dzwangg/SuppBuddy/hardware/cad/render/tex/breadboard.png

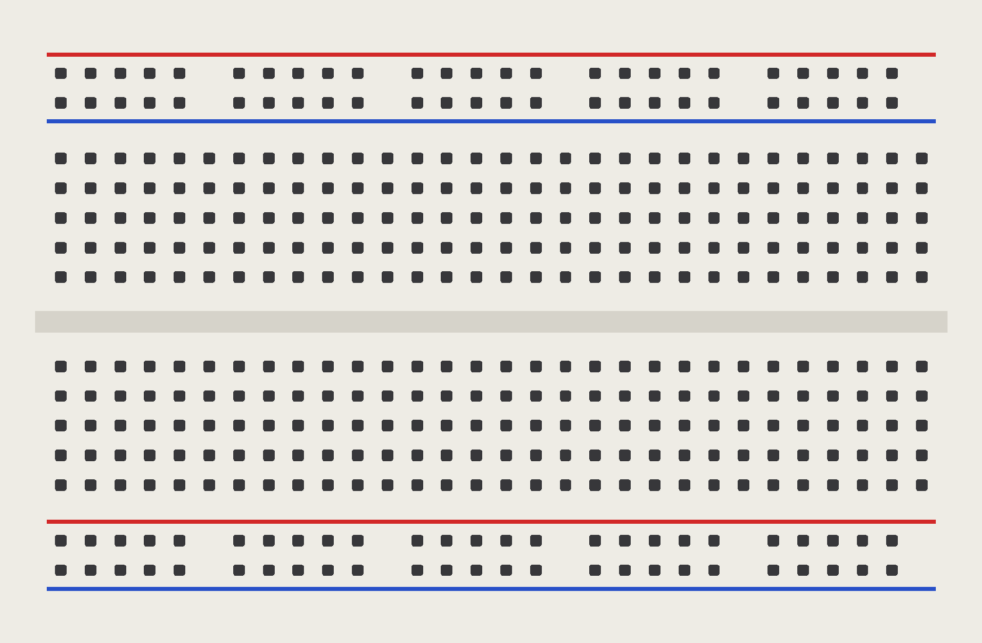
hardware/cad/render/tex/breadboard.png
