dzwangg/SuppBuddy/hardware/cad/render/tex/lcd_cutaway.png

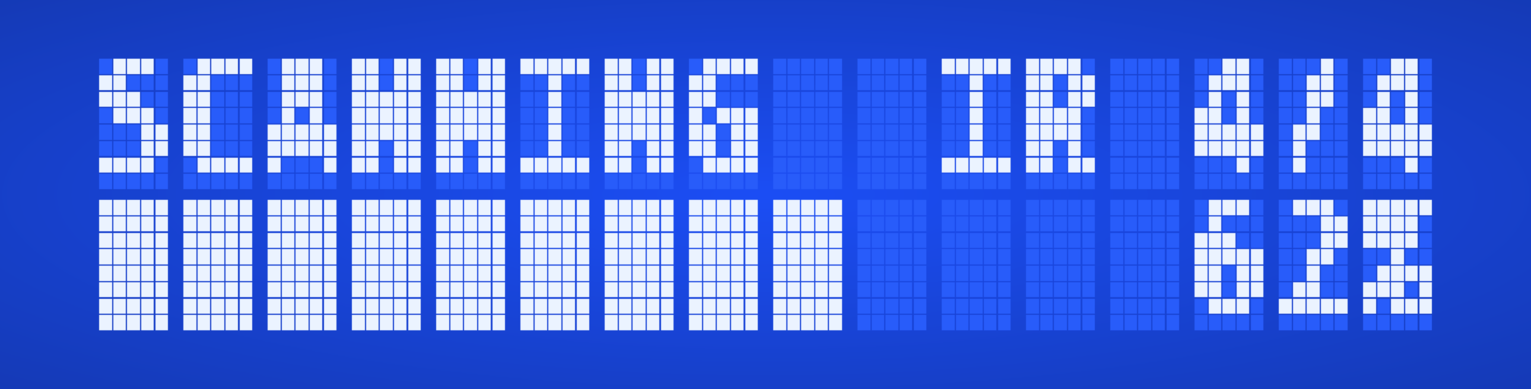
hardware/cad/render/tex/lcd_cutaway.png
