dzwangg/SuppBuddy/hardware/cad/render/tex/lcd_exploded.png

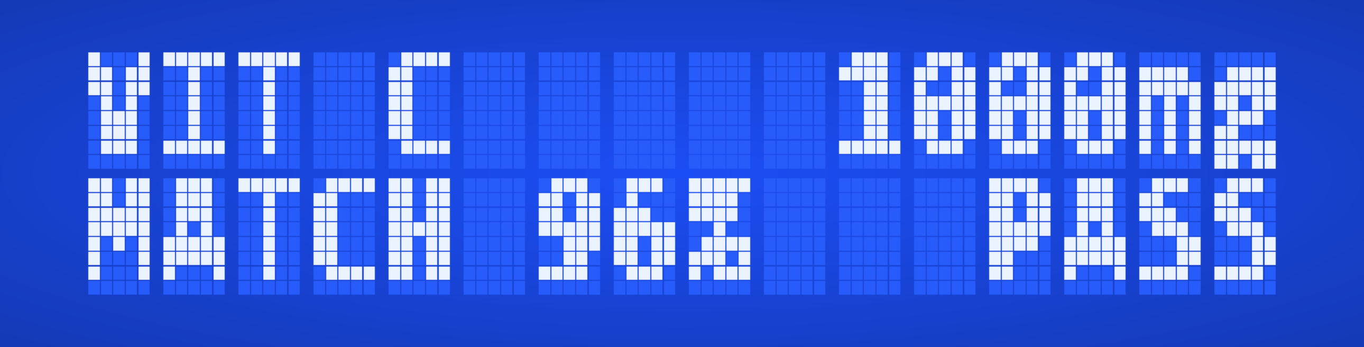
hardware/cad/render/tex/lcd_exploded.png
