dzwangg/SuppBuddy/hardware/cad/render/tex/lcd_hero.png

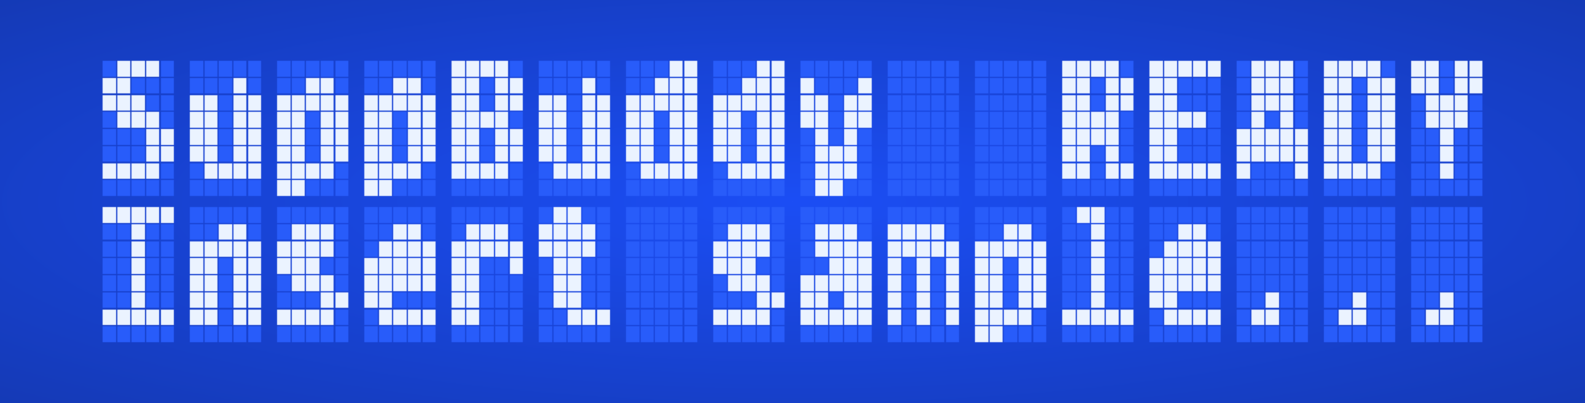
hardware/cad/render/tex/lcd_hero.png
