dzwangg/SuppBuddy/hardware/cad/render/stl/sleeve.stl

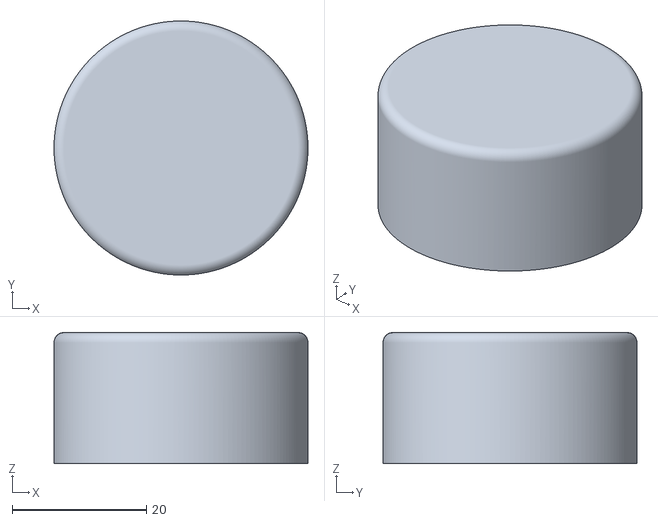
[picture p20: CAD file, 2026-11-09]
hardware/cad/render/stl/sleeve.stl
37.8 x 37.8 x 19.5
