dzwangg/SuppBuddy/hardware/stl/suppbuddy-v4-base.stl

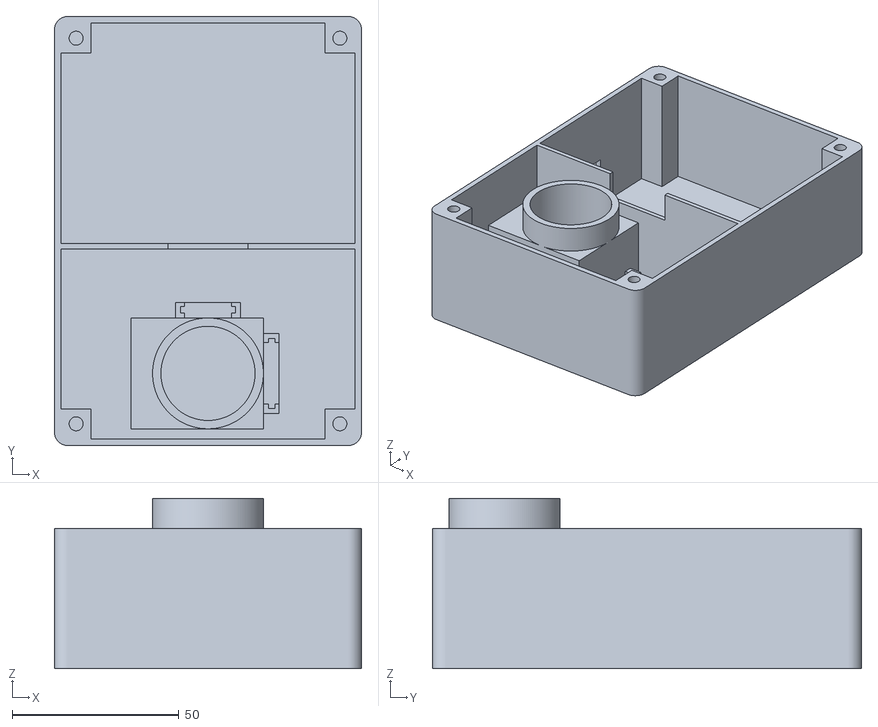
[picture p21: CAD file, 2026-11-12]
hardware/stl/suppbuddy-v4-base.stl
92.0 x 128.5 x 51.0
