dzwangg/SuppBuddy/hardware/stl/suppbuddy-v4-lid.stl

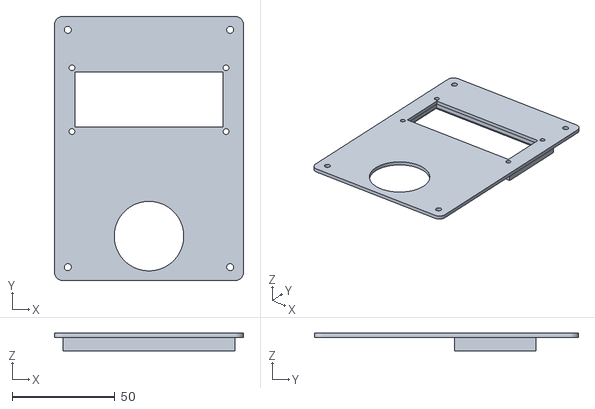
[picture p22: CAD file, 2026-11-12]
hardware/stl/suppbuddy-v4-lid.stl
92.0 x 128.5 x 8.60
