dzwangg/SuppBuddy/hardware/stl/suppbuddy-v3-sleeve.stl

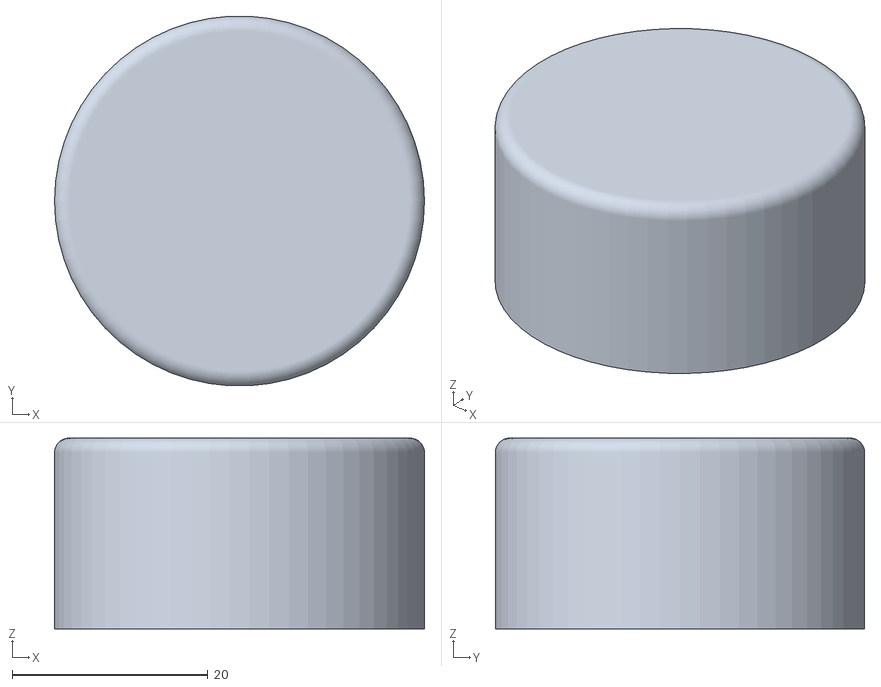
[picture p23: CAD file, 2026-11-09, an earlier design]
hardware/stl/suppbuddy-v3-sleeve.stl
37.8 x 37.7 x 19.5
