dzwangg/SuppBuddy/(list of files, cad)

Other CAD files:
hardware/cad/render/stl/base.stl
hardware/cad/render/stl/lid.stl
hardware/stl/suppbuddy-v4-sleeve.stl
hardware/stl/suppbuddy-v3-lid.stl
hardware/stl/suppbuddy-v3-base.stl
