dzwangg/SuppBuddy/(commit log)

2026-11-07 SupPal iPhone app and ESP32 BLE test sketch
    SwiftUI app for screening supplements with a cuvette light tester:
    - Bluetooth link to the ESP32 tester (Nordic UART: write "m", get one line of channel readings)
    - Water blank + sample measurement, absorbance spectrum chart, matching against reference spectra
    - Label photo and barcode lookup against the NIH Dietary Supplement Label Database
    - Claude analysis with web search, live research feed, and a verdict report
    - Test history and shareable report card image
    - Simulated tester in the iOS Simulator; logic self-check in checks/main.swift
    The API key goes in Secrets.xcconfig, which is gitignored. references.json holds placeholder demo spectra.
    C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
2026-11-07 backend push
    [tainted_supplements.csv]
2026-11-07 Connect the app to the backend and fix backend bugs
    Backend (backend/suppbuddy-backend):
    - Label reading used a forced tool call, which current Claude models reject; use
    structured output (messages.parse) at low effort (about 3 s per photo)
    - Agent no longer forces tool_choice; it asks once more, then keeps the code's report
    - Raise max_tokens for always-on thinking; web_search_20260209; agent effort medium
    - Recalls: one penalty per event, weighted by age and capped (Nature Made scored 0/100)
    - Adverse-event counts barely move the score; an empty tainted list is not a checked source
    - NIH name lookup requires the same brand; new barcode lookup flags a barcode
    registered to another brand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
2026-11-08 Add ESP32 optical tester firmware (LEDs, TCS34725, TSL2591) with README
    Standalone serial-only bench firmware in firmware/SupplementOpticalTester.
    Does not yet implement the SupPal BLE protocol.
2026-11-08 Match sensor saturation limits to the firmware's settings
    The backend flagged saturation at 65000 counts, but at the settings in
    firmware/SupplementOpticalTester the TCS34725 (50 ms) tops out at 21,504
    and the TSL2591 (100 ms) at 37,888, so saturated readings passed QC.
    Set the defaults to 21000 and 37000.
    The simulator and firmware stub used blank counts (green 22000, clear
    55000) the real TCS can't reach at 50 ms; lowered them so simulated and
    seed scans stay valid. Features are ratio-based, so results are unchanged.
2026-11-08 Protocol v3: Bluetooth firmware, fuller use of sensor data, safer crowd data
    Firmware (firmware/SupplementOpticalTester)
    - Speaks the app's Bluetooth protocol (v3) on top of the real sensor code;
    the same commands work from Serial Monitor for bench testing.
    - Each cycle (~1.4 s): a dark reading, then white, red, green and blue.
    TCS34725 averages 3 integrations; TSL2591 reports its infrared channel.
    - Fixed gains and integration times, reported in an "I" line.
    - Missing sensors are reported to the app as "X,<reason>".
    - Orange/yellow LED removed; lux and color-guess printouts removed.
    Backend
    - New "cycle" mode features: per-band color from each colored LED,
    scatter color exponent (par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
    [BleLink.cpp, BleLink.h, Config.h, LEDController.cpp, LEDController.h, LuxSensor.cpp, LuxSensor.h, Measurements.cpp]
2026-11-08 Keep the TCS34725's white LED off from firmware
    The breakout's white illumination LED is on unless its LED pin is pulled
    low, and it sits millimeters from the sensor: its glare bounces off the
    cuvette back into the sensor, and the in-run dark readings can't remove
    it because it changes with the sample.
    - Config.h: TCS_LED_PIN = 4 (wire the breakout's LED pin to GPIO 4).
    - RGBSensor::ledOff() drives it LOW; called first thing in setup() and
    again in RGBSensor::begin(), so it's off even if the sensor isn't found.
    setInterrupt(true) still covers boards with LED wired to INT.
    - status reports which pin holds the LED off.
    - Root README pin table and firmware README updated.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
2026-11-09 Add hardware CAD and docs, rename SupPal to SuppBuddy
    - hardware/: enclosure CAD scripts (V1-V3 Onshape builders, render pipeline),
    details.md (full hardware log) and ideas.md
    - README.md: rewritten as a short landing page for the hackathon project
    - documentation.md: technical documentation (how it works, science, hardware,
    architecture, setup, BLE protocol), with team credits
    - assets/: wiring diagram, pitch deck (PPTX + PDF) and photos
    - Rename SupPal -> SuppBuddy everywhere (app folder, Xcode project, bundle ID,
    BLE name, firmware stub); move firmware-stub/ into firmware/
    [base.stl, lid.stl, sleeve.stl]
2026-11-09 Link the Onshape CAD model from the README and documentation
2026-11-09 Add printable V3 STL files and link them from the docs
    Base, lid and vial cap sleeve exported from the DeviceHolder V3 Part Studio
    (mm), individually and as one zip, with printing tips in documentation.md.
    [suppbuddy-v3-base.stl, suppbuddy-v3-lid.stl, suppbuddy-v3-sleeve.stl]
2026-11-09 Point STL download links at hardware/stl/ instead of the removed zip
2026-11-12 Add CAD V4 with the light sensors swapped and point the docs at it
    V4 moves the TCS34725 into the in-line pocket opposite the LEDs and the
    TSL2591 into the 90-degree pocket, which is where the firmware and the
    wiring table already expect them. Everything else matches V3, so only the
    base changes.
    - hardware/cad/build_v4.py copies the DeviceHolder V3 Part Studio and
    redraws the two pocket and two slot sketches (12 API calls).
    - hardware/stl/: V4 STLs for the base, lid and sleeve. The V3 files stay.
    - README and documentation: the Onshape link, STL links, version table and
    part description now point at V4. The renders still show V3 and are
    captioned that way.
    - hardware/details.md recor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
    [suppbuddy-v4-base.stl, suppbuddy-v4-lid.stl, suppbuddy-v4-sleeve.stl]
